andrei258258/peltier-control/README.md

# peltier-control
This repository have the description and the "how to do" a peltier control used for cryotherapy. This work was done by Andrei Donati e Fernando Battisti in 2017 and it's open source for non commercial uses.
