andrei258258/peltier-control/Gela Pele.STL

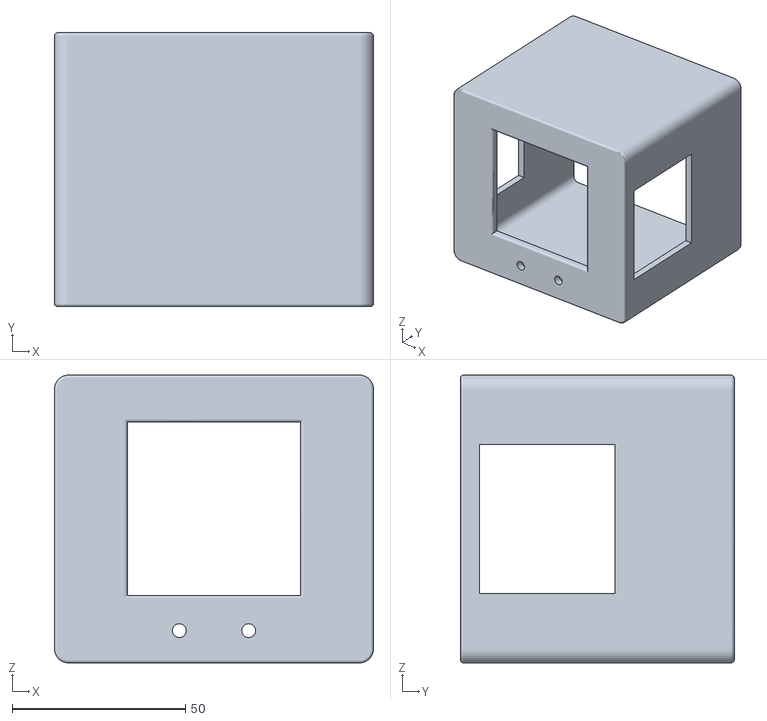
[picture p17: CAD file, 2017-07-03]
Gela Pele.STL
92.0 x 79.0 x 83.0
