andrei258258/peltier-control/Dados Experimentais.xlsx

Sheet: Plantas
Teste2
G(S)= | e(-4,2S) | 2.8
 |  | 24,1S+1
Teste3
G(S)= | e^(-4s) | 2.17
 |  | 28,4S+1
Teste4
G(S)= | e(-4,5S) | 1.92
 |  | 18,4S+1

Sheet: teste1
indice | Tempo (s) | Temperatura (ºC) | saida | Tensão
0 | 0 | 25 | 0 | 0
2 | 0.2 | 25 | 0 | 0
4 | 0.4 | 25 | 0 | 0
6 | 0.6 | 24 | 0 | 0
8 | 0.8 | 25 | 0 | 0
10 | 1 | 26 | 0 | 0
12 | 1.2 | 25 | 0 | 0
14 | 1.4 | 24 | 0 | 0
16 | 1.6 | 25 | 0 | 0
18 | 1.8 | 25 | 0 | 0
20 | 2 | 25 | 0 | 0
22 | 2.2 | 25 | 0 | 0
24 | 2.4 | 25 | 0 | 0
26 | 2.6 | 25 | 0 | 0
28 | 2.8 | 25 | 0 | 0
30 | 3 | 25 | 0 | 0
32 | 3.2 | 25 | 0 | 0
34 | 3.4 | 25 | 0 | 0
36 | 3.6 | 25 | 0 | 0
38 | 3.8 | 25 | 0 | 0
40 | 4 | 25 | 0 | 0
42 | 4.2 | 25 | 0 | 0
44 | 4.4 | 25 | 0 | 0
46 | 4.6 | 24 | 0 | 0
48 | 4.8 | 25 | 0 | 0
50 | 5 | 25 | 0 | 0
52 | 5.2 | 25 | 0 | 0
54 | 5.4 | 25 | 0 | 0
56 | 5.6 | 25 | 0 | 0
58 | 5.8 | 25 | 0 | 0
60 | 6 | 25 | 0 | 0
62 | 6.2 | 25 | 0 | 0
64 | 6.4 | 25 | 0 | 0
66 | 6.6 | 25 | 0 | 0
68 | 6.8 | 24 | 0 | 0
70 | 7 | 25 | 0 | 0
72 | 7.2 | 25 | 0 | 0
74 | 7.4 | 25 | 0 | 0
76 | 7.6 | 25 | 0 | 0
78 | 7.8 | 25 | 0 | 0
80 | 8 | 25 | 0 | 0
82 | 8.2 | 24 | 0 | 0
84 | 8.4 | 25 | 0 | 0
86 | 8.6 | 25 | 0 | 0
88 | 8.8 | 25 | 0 | 0
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
